ozarchie/EQMOD-ETX/Documentation/images/HBX- Message.jpg

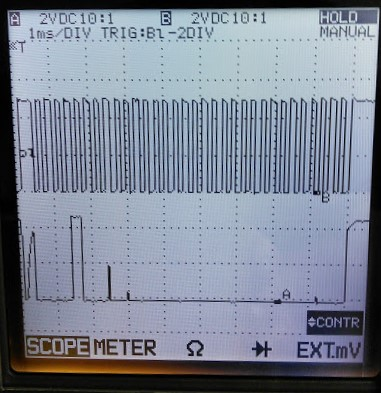
Documentation/images/HBX- Message.jpg
