ozarchie/EQMOD-ETX/Documentation/images/HBX- First Bit.jpg

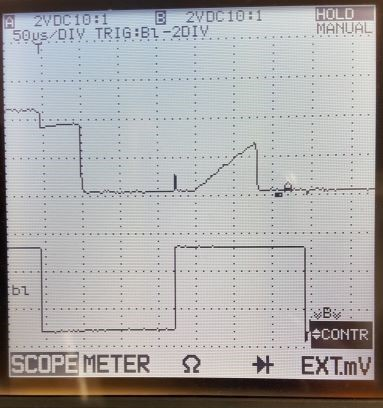
Documentation/images/HBX- First Bit.jpg
