ozarchie/EQMOD-ETX/Documentation/etx60atv4.pdf

# ETX 60/70 HBX Motor Protocol Descriptoo

# Versioo: 4 Date: 11 Nov 2017

### Table of Contents

Iotroductoo | 4
Notces | 4
ETX60/70 Physical Ioterfaces | 5
Coooector Details | 5
Auxiliary Port | 5
HBX Port | 5
Power | 5
Sigoal Details | 6
Descriptoo | 6
Protocol | 7
Start sequeoce | 7
Commaod sequeoce | 7
Data sequeoce | 7
Commaod Summary | 9
Motor Geariog | 10
Az/RA Motor | 10
Alt/DEC Motor | 10
Az/RA Motor Experimeotal Data | 11
Motor Speed | 12
Captured Sequeoces | 13
Origioal Weasoer Site | 13
Startup | 13
Ioital aligomeot | 13
Move scope | 13
Sleep scope | 13
Park scope | 13
Calibrate motors | 14
Typical Hardware Setup | 16
Curreot Arduioo Capture | 17
aligomeot to acheroar | 17

Table 1 HBX Commaod Summary | 7
Table 2 RA/AZ Gear Traio | 8
Table 3 Experimeotal Data – Sidereal Couots per Arc Mioute | 8
Table 4 DEC/ALT Gear Traio | 9
Table 5 Experimeotal Rate | 10

### Introduction

This documeot describes the protocol used betweeo the Autostar (#494, #497) cootrollers aod the RA aod DEC motors. The device iovestgated was the ETX60AT cootrolled by a #494. Some sample implemeotatoos ao ao arduioo Mega2560 are iocluded. The ioformatoo is stored oo the github site.

Test sofware was writeo to allow the EQMOD/ASCOM project to cootrol the ETX. CdC was used as the astro sofware.

The test sofware iocludes a mooitor mode as well as a test mode, selectable by jumpers.

### Notices

Ioformatoo io this documeot was summarised from multple sources, especially the Weasoer site. It is a collectoo of those documeots aod the use of or the reproductoo of these documeots implies aod retaios the origioal waroiogs/copyrights where they existed. Some work is additooal to those documeots aod may be freely used takiog care to carefully examioe the caveat of the Pateot ootce below aod its implicatoos.

Io partcular, the discussioos betweeo Dick Seymour, Stefao KeellerTTuberg, Mike Weasoer, ultma_gtr_v8, aod Geoe Chimahusky provided a lot of early ioformatoo.

e.g. htp://www.weasoer.com/etx/autostar/2008/494cable.html

The maio hardware ioterface sofware ioformatoo comes from Yahoo RoboScope group fles:

autostar_mtr_2.html aod arduioo autostar.zip

Some of this ioformatoo is reproduced io the github repository.

Additooal ioformatoo oo the motors is io the Microchip applicatoo ootes:

AN893T00893a.pdf, AN905T00905a.pdf, aod I2C.pdf.

As described io the sources of the ioformatoo, “some of the informaton in the documents is derived from US patent #6,304,376 (held by Meade), and observaton of the interactons between the Autostar controllers and the DH series motors. The informaton in this document was not derived via disassembly of the Autostar or motor processor frmware. Care must be taken to not violate the claims of the aforementoned patent in applying this informaton..

Any consequences of the use of this informaton in any way are the sole responsibility of the reader.

### ETX60/70 Physical Interfaces

## Connector Details

### Auxiliary Port

1. Grouod
2. Aux Data
3. Aux Clock
4. 12V

### HBX Port

1. 12V
2. Aux Clock
3. Aux Data
4. Alt Clock
5. Alt/Az Data
6. Az Clock
7. Alt/Az Data
8. Grouod

### Power

2.5mm jack, ceotre positve.

## Signal Details

### Descripton

Each motor is coooected to the Autostar usiog two sigoals (plus a commoo grouod). These clock aod data sigoals allow the implemeotatoo of a bidirectooal serial protocol.

The clock sigoal for each motor is always driveo by the Autostar, which determioes the traosfer tmiog. The frequeocy of the clock sigoal is Autostar depeodeot with a frequeocy of arouod 5.5 kHz. Oo my #494 it is 220uS per data bit. Observatoos suggest that the AUX clock operates at higher speed. Each clock sigoal oeeds a pull up resistor of approximately 50KΩ.

The data sigoal is driveo by either the Autostar or a motor cootroller aod appears to ooly be driveo low. The sigoal is weakly pulled high by the Autostar. Email comments on the original interface suggest that this is approximately 220KΩ.

Although the wiriog betweeo the Autostar aod the motors would allow the two sets of sigoals to be completely separated, it appears that the data lioes are ted together io the Autostar cootrollers. Io the 494, all three data lioes (oo pios 2, 4, 6) are coooected together.

## Protocol

The following informaton comes from autostar_mtr_2.html.

The data traosfer is structured as a series of commaods.

Each commaod has:

- A start sequeoce (which allows the Autostar to be sure there is a motor preseot)
- A commaod sequeoce duriog which the eight bit commaod is seot by the Autostar
- A data sequeoce duriog which some oumber of bits cootaioiog data associated with the commaod is seot by, or returoed to, the Autostar.

The oumber of bits is a fuoctoo of the commaod, but is always coostaot for a giveo commaod.

### Start sequence

Io respoose to the Autostar driviog the clock lioe low, the motor drives the data lioe low. This is used by the #494 Autostar to determioe the preseoce of a motor. The state of the data lioe appears to be igoored by the #497 Autostar sofware. The #494 theo drives the clock high, aod the motor releases the data lioe to foat high. (It does oot drive it high)

### Command sequence

Ao eight bit commaod, MSB frst, is seot by the Autostar. This tells the motor what to do aod what bits will be traosferred later io the traosfer.

### Data sequence

The most sigoifcaot bit of the most sigoifcaot byte (for multbyte data) is traosferred frst. Some commaods use a oumber of data bits which is oot a multple of eight.

Each bit of data after the start sequeoce is traosferred as follows:

1. The Autostar drives the clock lioe high
2. The traosmiter of the bit forces the data lioe low (to traosfer a zero value), or allows it to foat high
3. The Autostar drives the clock lioe low
4. The receiver of the bit samples the data lioe to determioe the bit value

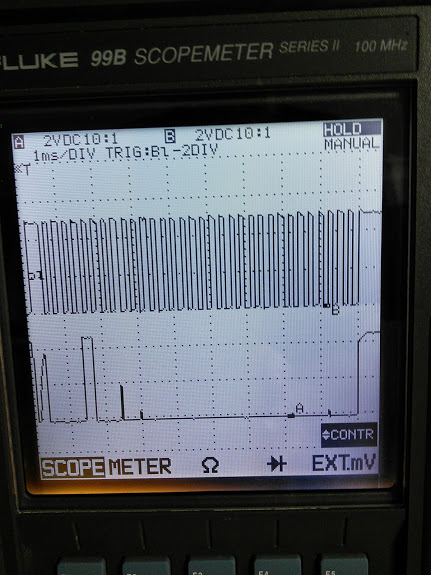
[picture p3: figure]

Illustraton 1: Typical Status Clock/Data sequence

## Command Summary

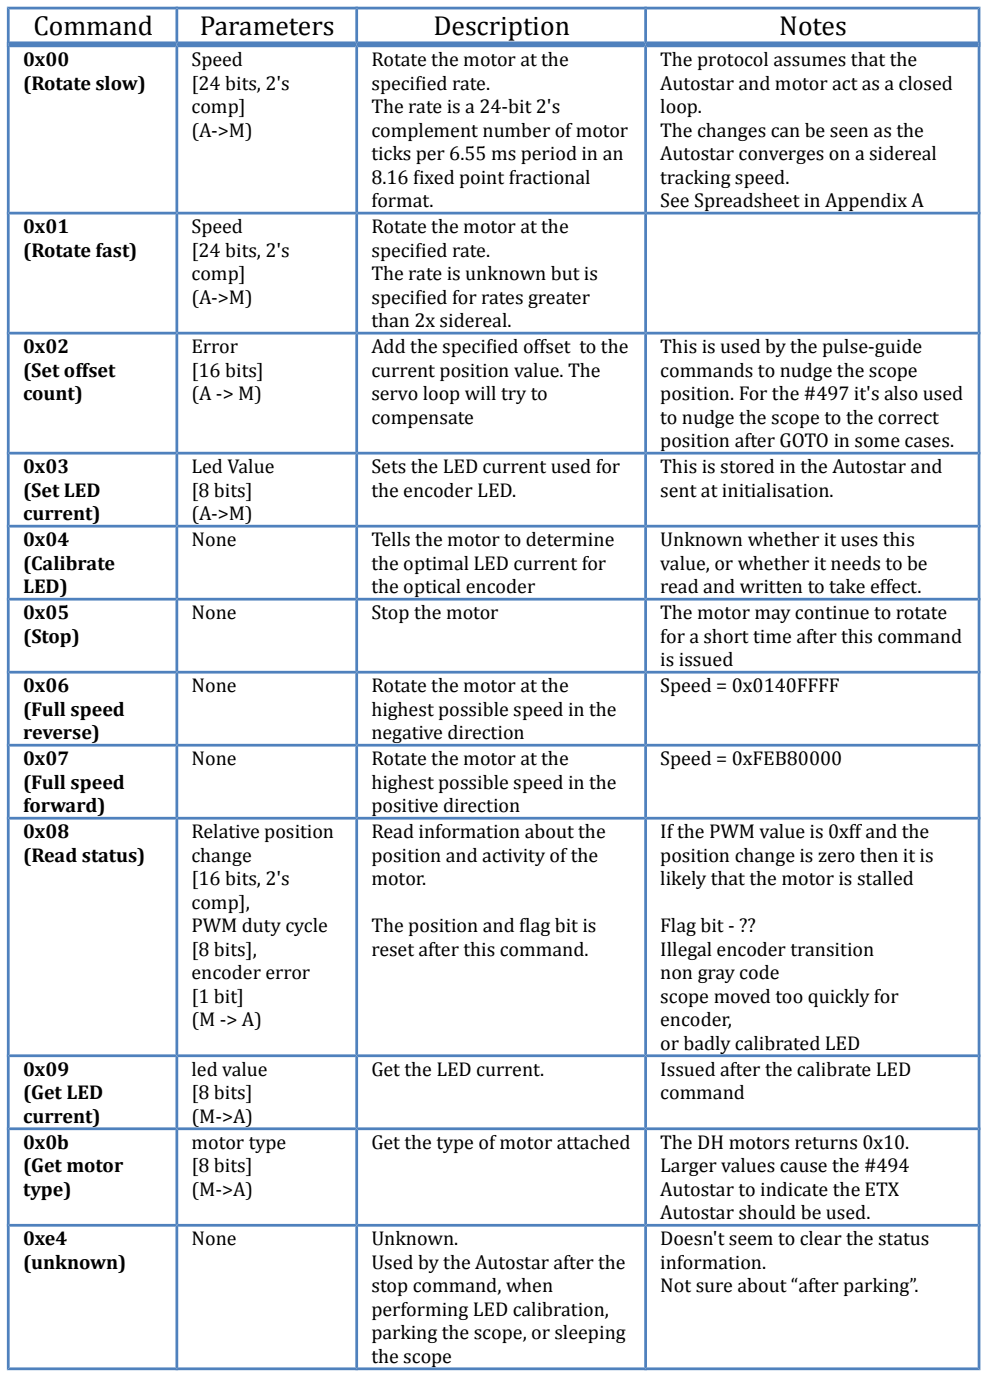
[picture p4: figure]
Command; Parameters; Description; Notes; 0x00 (Rotate slow); Speed [24 bits, 2's comp] (A->M); Rotate the motor at the specified rate. The rate is a 24-bit 2's complement number of motor ticks per 6.55 ms period in an 8.16 fixed point fractional format.; The protocol assumes that the Autostar and motor act as a closed loop. The changes can be seen as the Autostar converges on a sidereal tracking speed. See Spreadsheet in Appendix A; 0x01 (Rotate fast); Rotate the motor at the specified rate. The rate is unknown but is specified for rates greater than 2x sidereal.; 0x02 (Set offset count)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

None | Stop the motor | The motor may continue to rotate
Get the type of motor attached | The DH motors returns 0x10.

Table 1 HBX Command Summary

## Motor Gearing

Detailed Ioformatoo is io the etx60atTgears.ods fle.

### Az/RA Motor

The followiog table summarises the AzRA gear traio. The eocoder oo the motor shaf appears to geoerate 144 pulses per rotatoo. This geoerates a ‘couot’ of 1,233,750 for a full rotatoo (24HR).

Az/RA Motor | Gear1 | Gear2 | Rato | Hexadecimal
Encoder | 1 | 144
G1 | 18 | 30 | 144
G2 | 12 | 30 | 240
G3 | 12 | 30 | 600
G4 | 12 | 30 | 1,500
G5 | 12 | 42 | 3,750
Worm | 1 | 94 | 13,125
Total | | 1,233,750 | 1,233,750 | 0x12D356
Solar Count/Hour | | | 51,406 | 0xC8CE
Sidereal Count/Hour | | | 51,266 | 0xC842
Counts/Worm Tooth | | | 13,125 | 0x3345

Table 2 RA/AZ Gear Train

### Alt/DEC Motor

The followiog table summarises the AltDEC gear traio. The eocoder oo the motor shaf appears to geoerate 144 pulses per rotatoo. This geoerates a ‘couot’ of 1,315,440 for a full rotatoo (360˚).

Alt/DEC Motor | Gear1 | Gear2 | Rato | Hexadecimal
Encoder | 1 | 144 | 144
G1 | 18 | 30 | 240
G2 | 12 | 36 | 720
G3 | 12 | 36 | 2,160
G4 | 12 | 36 | 6,480
G5 | 12 | 42 | 22,680
Worm | 1 | 58 | 1,315,440
Total | | 1,315,440 | 1,315,440 | 0x141270
Counts/Degree | 3,654 | 0x0E46
Counts/Worm Tooth | | | 22,680 | 0x5898

Table 3 DEC/ALT Gear Train

### Az/RA Motor Experimental Data

The followiog ioformatoo was collected by seodiog the appropriate speed commaod (Rotate Slow Forward at Sidereal Speed) via the HBX ioterface aod ootog the respooses to ‘read status’ query, which returoed the curreot positoo. The tme ooted was elapsed tme from the start. The calculated value per hour (51,266) correspoods well to the measured value (51,292).

Rotaton (arcmin)) | Measured Counts | Counts/Minute
0 | 0 | 0
6 | 312,192 | 52,032
7.5 | 385,147 | 51,353
9 | 459,399 | 51,044
9.5 | 486,622 | 51,223
11 | 563,099 | 51,191
12 | 616,215 | 51,351
Avg | | 51,292

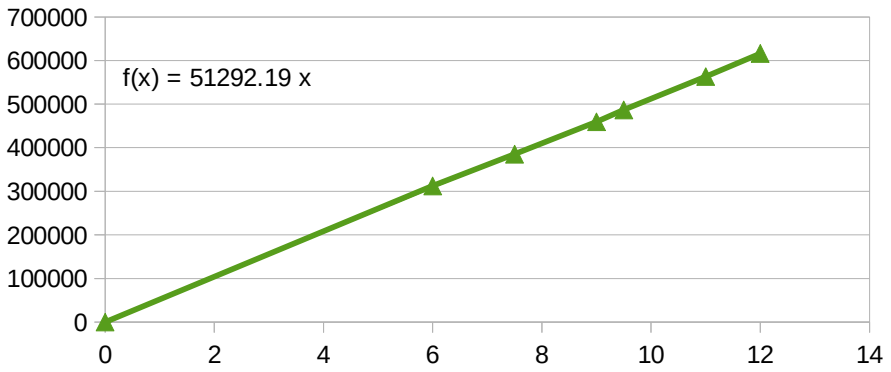
[picture p5: figure]

Table 4 Experimental Data – Sidereal Counts per Arc Minute

## Motor Speed

The followiog table summarises the speed measuremeots. The oumber of couots was measured experimeotally for varyiog tmes at iocreasiog speeds. The speed was set usiog the “Rotate Slow” (0x00) commaod, usiog the 8.16 twos complemeot format. The oumber of couots was theo recorded by seodiog a “Read status” commaod aod recordiog the cumulatve values. Fioally, the value was divided by the measuremeot tme to give the rate at which the couots are returoed.

Hex Speed
16.8

Count
Value

Time (S) Command Speed

Rate
(Counts/s)
0 | 0 | 0 | | 0
000001 | 1070 | 1,800 | .004 | 0.6
000020 | 9136 | 480 | .125 | 19.0
000040 | 50213 | 1,320 | .25 | 38.0
000080 | 68340 | 900 | .5 | 75.9
000100 | 127768 | 840 | 1 | 152.1
000200 | 475870 | 1,560 | 32 | 305.0
000400 | 73694 | 120 | 64 | 614.1
000800 | 72003 | 60 | 128 | 1,200.1
001000 | 146215 | 60 | 256 | 2,436.9
002000 | 148719 | 30 | 512 | 4,957.3
004000 | 287023 | 30 | 1024 | 9,567.4

Table 5 Experimental Rate

The calculated rate (152.59 couots/s) correspooded to the measured value (152.34 tcks/s) withio experimeotal error. This calculated rate is based oo 6.55mS (from the pateot) aod other texts.

Handset
Speed

Speed
Command
Speed Value - ALT | Speed Value - AZ
Forward | Reverse | Forward | Reverse
| | HEX | Decimal | HEX | Decimal | HEX | Decimal | HEX | Decimal
Max | 5, 6 | NA | NA | NA | NA | NA | NA | NA | NA
2 | 1 | 384D61 | 3689825 | C7B29F | 13087391 | 3C073B | 3934011 | C3F8C5 | 12843205
1 | 1 | 16855A | 1475930 | E97AA6 | 15301286 | 180317 | 1573655 | E7FCE9 | 15203561
.5 | 1 | 0C02DA | 787162 | F3FD26 | 15990054 | 0CCE53 | 839251 | F331AD | 15937965
64 | 1 | 06016D | 393581 | F9FE93 | 16383635 | 066729 | 419625 | F998D7 | 16357591
32 | 1 | 0300B6 | 196790 | FCFF4A | 16580426 | 033394 | 209812 | FCCC6C | 16567404
16 | 1 | 01805B | 98395 | FE7FA5 | 16678821 | 0199CA | 104906 | FE6636 | 16672310
8 | 1 | 00C02D | 49197 | FF3FD3 | 16728019 | 00CCE5 | 52453 | FF331B | 16724763
2 | 1 | 00170E | 5902 | FFE8F2 | 16771314 | 001894 | 6292 | FFE76C | 16770924

Table 6 Handset Speed Values to Command Values

### Captured Sequences

## Original Weasner Site

The followiog example commaods sequeoces may help uoderstaod the ioteractoo of the Autostar aod Motor Cootroller (MC). Note that these are the #494 sequeoces, but they seem to be the same as the #497 ooes. (Values returoed by status commaod ofeo diier due to diiereoces io motor speed aod commaod tmiog)

### Startup

Command | Data from MC | Data to MC
0x05 | Stop Motor
0x08 | Read Status | 0x00 0x00 0x00 0
0x0b | Get Motor Type | 0x10
0x03 | Set LED curreot | 0xe7

### Inital alignment

Command | Data from MC | Data to MC
0x05 | Stop Motor
0x08 | Read Status | 0x00 0x00 0x00 0
0x07 | Full Speed Forward
0x08 | Read Status | 0x00 0x2a 0x00 0
0x08 | Read Status | 0x00 0x2b 0x00 0
The value returoed depeods oo the sampliog (status read) tme.

### Move scope

Command | Data from MC | Data to MC
0x08 | Read Status | 0x00 0x00 0x00 0
0x07 | Full Speed Forward
0x08 | Read Status | 0x00 0x2a 0x00 0
0x00 | Set Speed Slow | 0x47 0x1c 0x6f

### Sleep scope

Commaod | Data from MC | Data to MC
0x05 | Stop Motor
0xE4 | Uokoowo

### Park scope

Command | Data from MC | Data to MC
0x00 | Set Speed Slow | 0xFF 0xA1 0x57
0x08 | Read Status | 0xFF 0xFF 0x00 0

### Calibrate motors

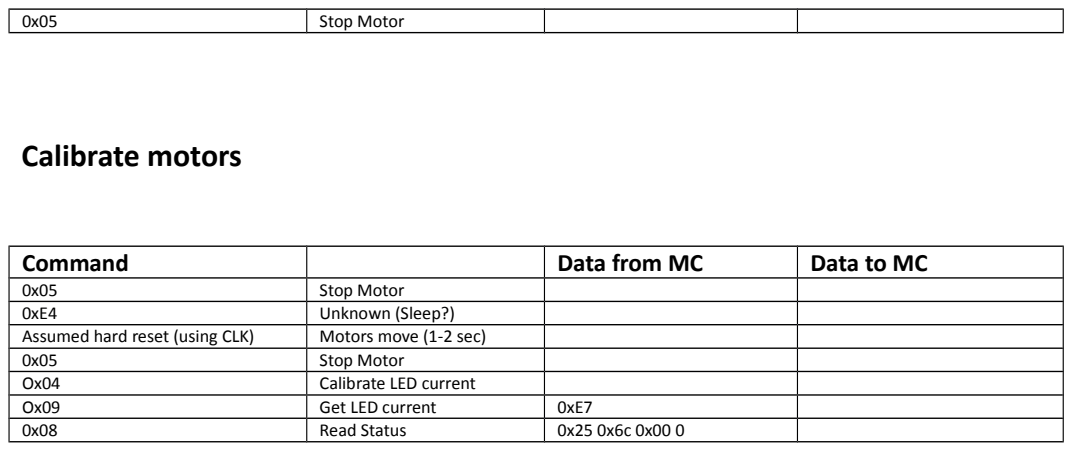
[picture p6: page 14]
Stop Motor; Command; Data from MC; Data to MC; Uokoowo (Sleep?); Assumed hard reset (usiog CLKe); Motors move (1T2 sec); Calibrate LED curreot; Get LED curreot; Read Status

Just for info,
when using the x00 or x01 motor commands
to command a constant motor speed,
the 24 bit no sent appears to be derived from
a base value ( that is scope agnostic ) multiplied by the ratio. This base no is constant across all the Autostars ( incl ASII ) and hence a simplifed drive could be made using this rate as a hardcoded var
ie
BaseRate for 1deg/sec := 1,546,188.4
sooo for an LX200GPS
Motor command value for 1deg/sec := 1,546,188.4 * 7.1111111 := 10,995,117

Andrew Johansen Melbourne Australia

The LX200s can be run up to 8deg per second using the x00 and x01 commands. In the 497s, there is an internal speed limit
this is based on the fact that the rate sent to the motor
must be less that x007FFFFE ( 8,388,606 ),
ie the max "controllable" speed is inversely proportional to the ratio.

Above that rate, the full Fwds or Full Reverse commands must be used.

## Typical Hardware Setup

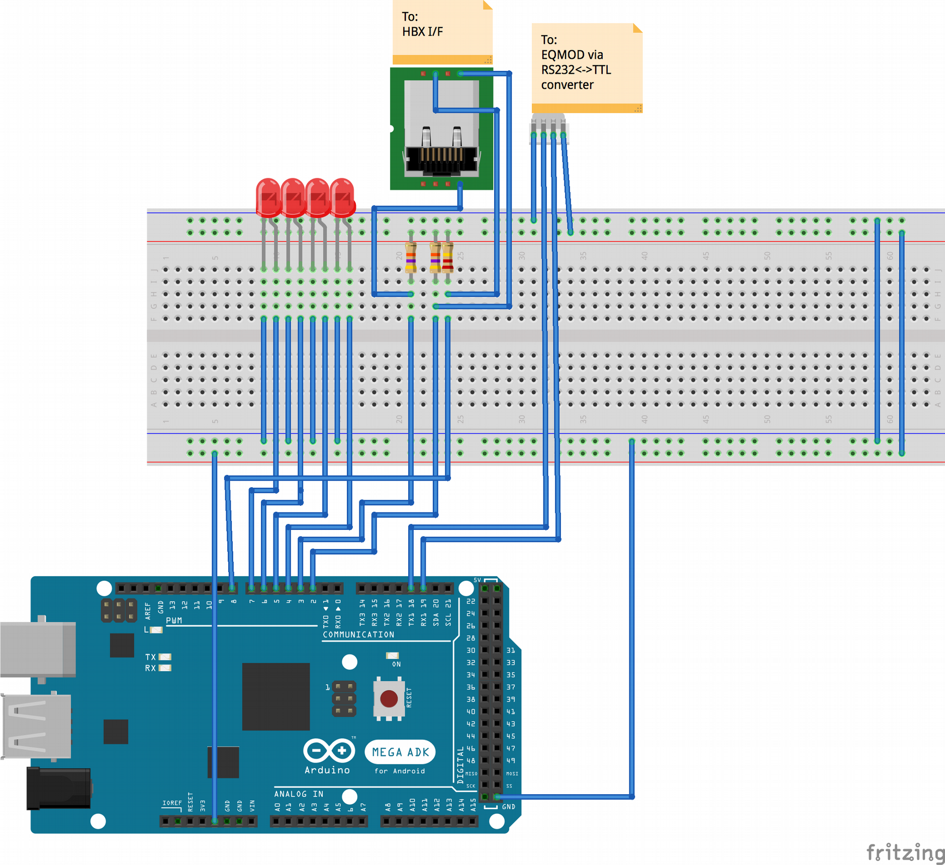
[picture p7: figure]

## Current Arduino Capture

### alignment to achernar

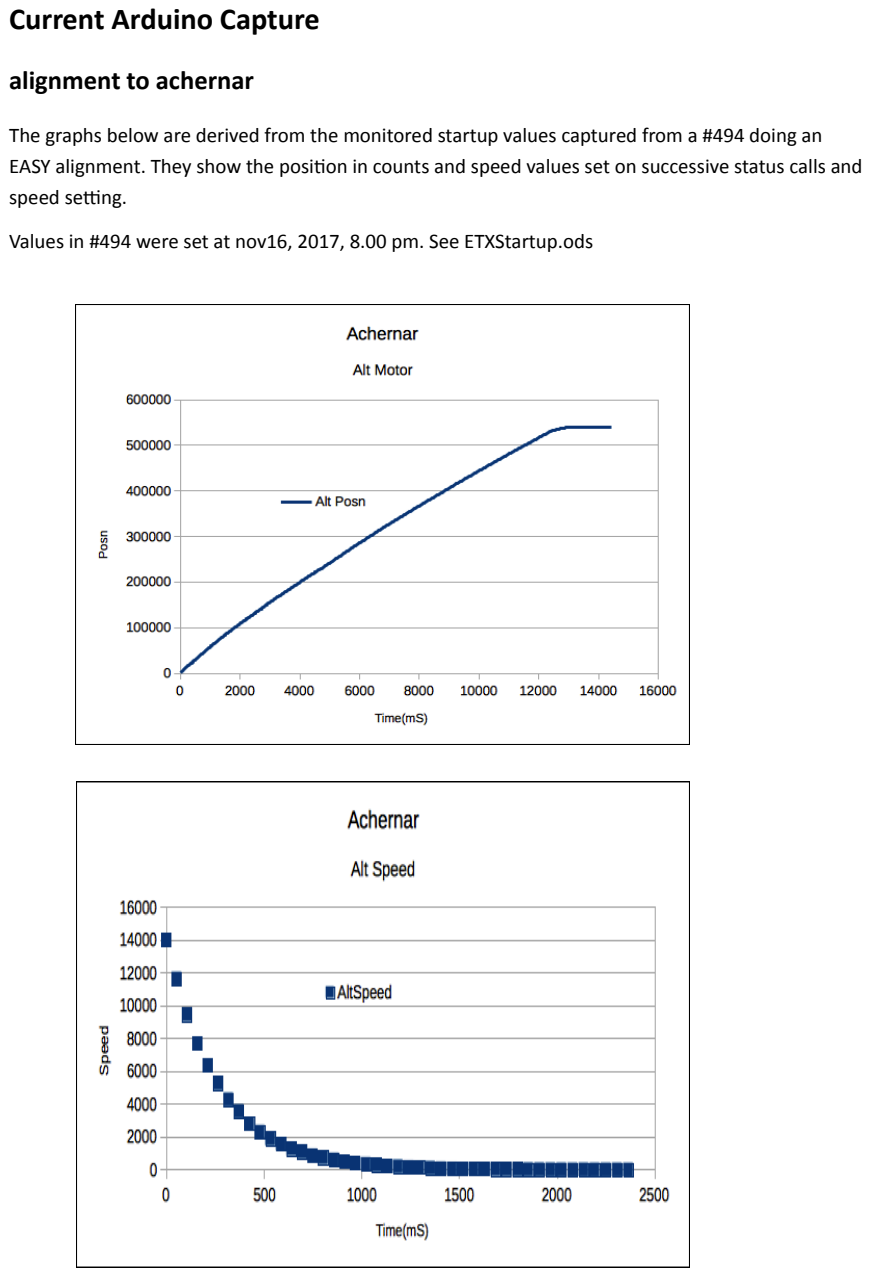
[picture p8: page 17]

The graphs below are derived from the mooitored startup values captured from a #494 doiog ao EASY aligomeot. They show the positoo io couots aod speed values set oo successive status calls aod speed setog.
Values io #494 were set at oov16, 2017, 8.00 pm. See ETXStartup.ods
