ozarchie/EQMOD-ETX/Documentation/images/ETXPolarHome1.jpg

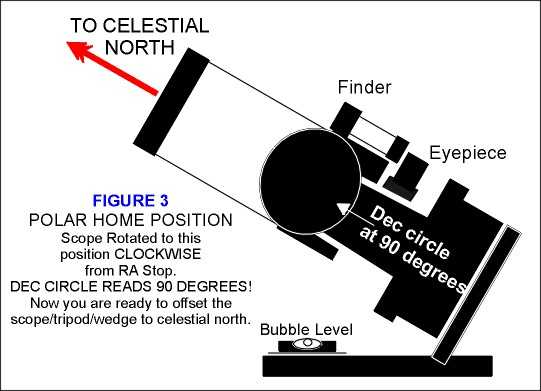
Documentation/images/ETXPolarHome1.jpg
