ozarchie/EQMOD-ETX/Documentation/images/ETXPolarHome2.jpg

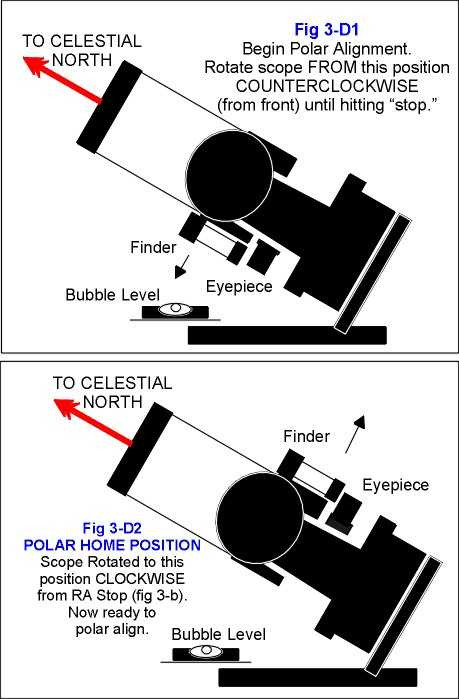
Documentation/images/ETXPolarHome2.jpg
