ozarchie/EQMOD-ETX/Hardware/EQG2HBXESP32_bb.png

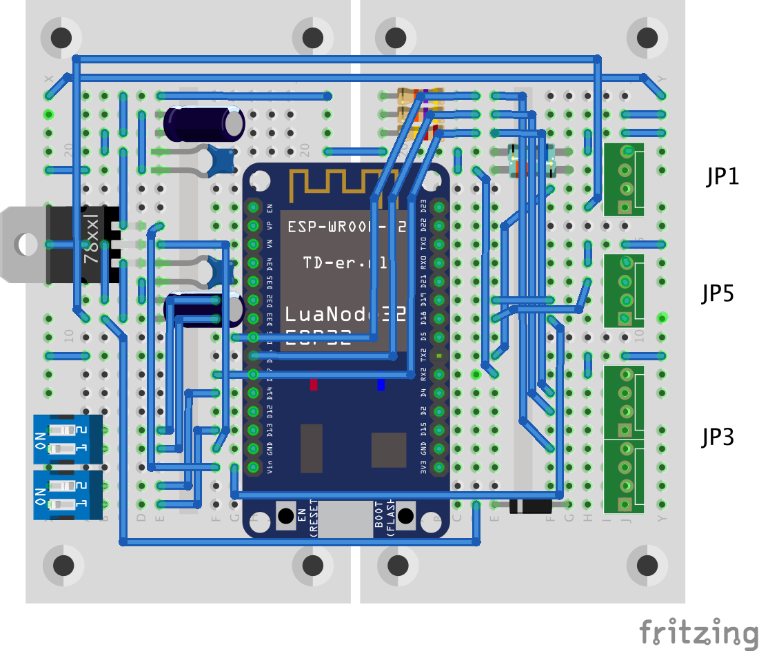
Hardware/EQG2HBXESP32_bb.png
