ozarchie/EQMOD-ETX/Hardware/EQG2HBXESP32_schem.png

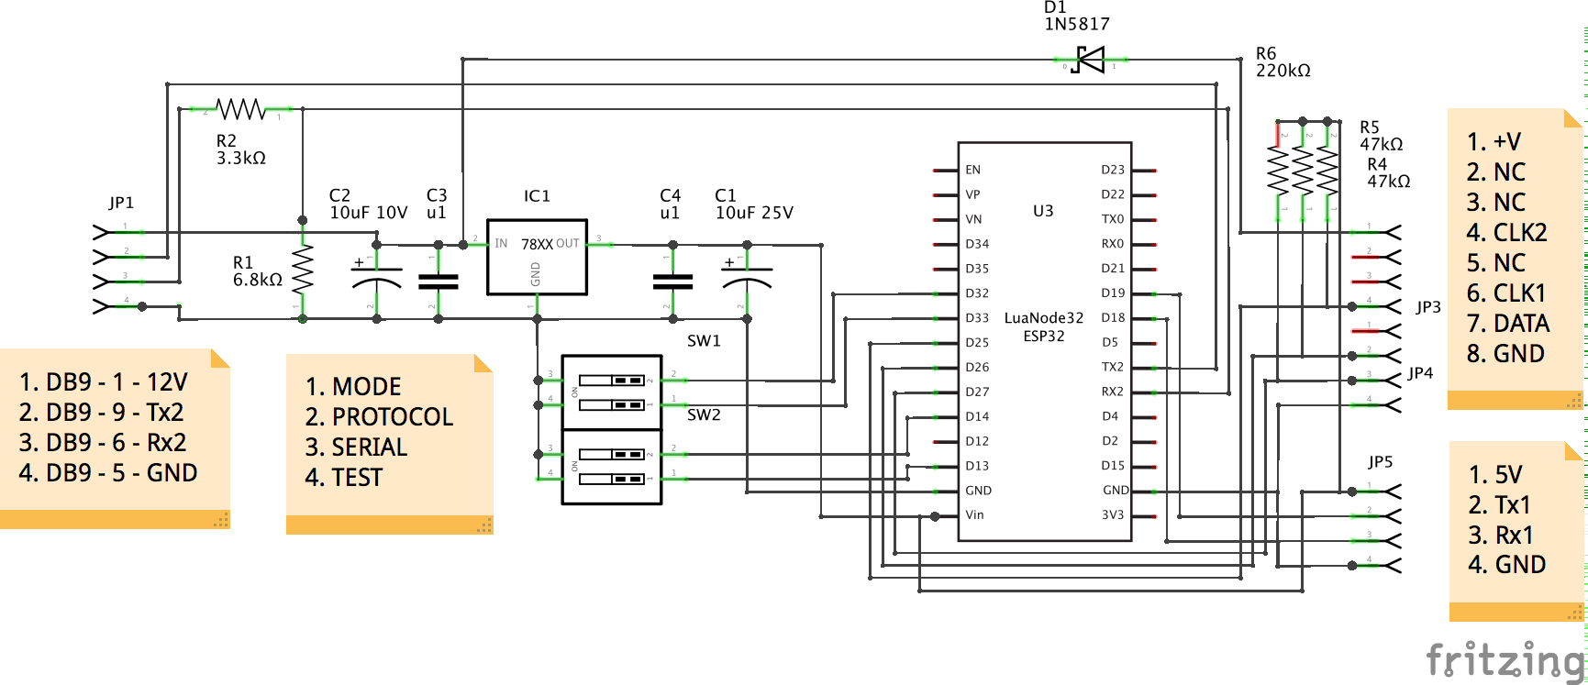
Hardware/EQG2HBXESP32_schem.png
