ozarchie/EQMOD-ETX/Hardware/HBX2EQG_bb.png

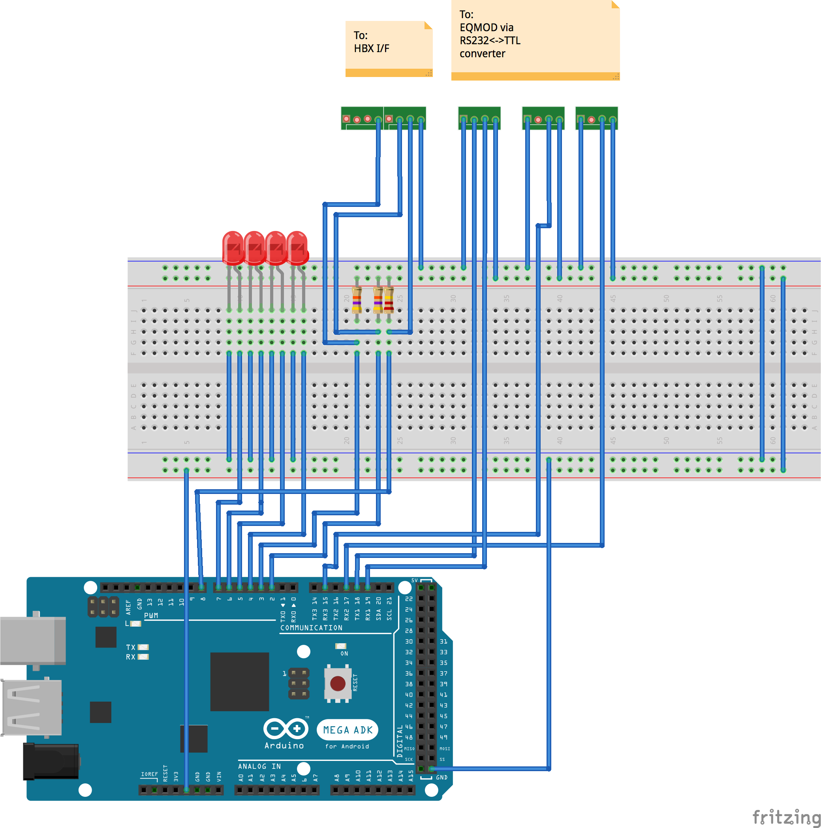
Hardware/HBX2EQG_bb.png
