ozarchie/EQMOD-ETX/Software/EQG2HBX/EQG2HBXE32/data/eq.gif

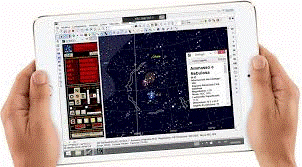
Software/EQG2HBX/EQG2HBXE32/data/eq.gif
