ozarchie/EQMOD-ETX/(threads)

Thread 2 (2021-12-18):

Setting up on Arduino

morzineIT, 2021-12-18:
Hi John,
Thanks for your work. I have ordered the ESP board from JLC, but I am a little confused
You make several reference to a an arduino controller - but all the code seems to be for an ESP
Did you move from Arduino to ESP to get wifi functionality ?
Is there a pure arduino version ? It looks like the level shifting would be easier with arduino - plus I have a mega sat on my desk, and I have to wait for the ESP PCB to come from China

Sorry to raise this as an issue, but it seems the only way to have comms on this platform

Lee

ozarchie, 2021-12-19:
Hi Lee,
No problems.
I have not worked on this for a while, but I will help you as much as I can.
The ESP was chosen for combined BT/WiFi functionality.
The Meade ETX series has an internal battery that makes it a neat portable unit.
The motivation for using the Skywatcher protocol was twofold.

1. I was familiar with EQMOD, so I could see the benefits of the PC based planetarium programs - moon mosaic, view list etc
2.  I was using the Skywatcher phone app, which allowed me a nice portable unit for grandkids.

The arduino code was implemented in the early days to debug what I could of the protocol. But now I use platformIO as it is a much better development platform. You can easily use the mega, but will lose the WiFi functionality. You may also have to look at the EEPROM libraries for storage.

morzineIT, 2021-12-19:
Thanks for your response.
Like you I got into astro/electronics to inspire my kids (grandkids in your
case)
I have done quite a few astro-automation projects (dome, focuser,filters
etc) and want to be able to get deeper inside the mount software /hardware.
I have ordered a copy if the pcb you designed, but won't receive it for a
week or two.
I have the mega on my desk and it seems to make the level shift easier.

would the 50k /220k resistor combination apply to the arduino voltages or
is that for 3.3v ?

It occurred to me that the new arduino mega with esp onboard may be the
easiest solution now. I have one, but haven't used it at all yet.

I think that combined with a raspberry pi, we could create an open source
version if the 'smart scopes' (unistellar etc). It would be very cool to
take a scope in your backpack, battery powered that you could pop down, do
some automated plate solving and be imaging in minutes.  My main astro gear
is RASA, so curious friends always want to tske a look and I see this as a
way to do that.

Would it be okay if I run questions by you from time to time please ?

regards

Lee

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

ozarchie, 2021-12-19:
Hi Lee,

No problems with giving you some help.

I am away on Festive duties at the moment, but will put some assembly photos in the documentation section when I get back home.

I hope you realize this code translates low-level motor control protocol for the Meade ETX series to low level motor control protocol for the Skywatcher EQx series. This effectively allows the Meade ETX mount to masquerade as an EQx mount.

I am not sure it has much application for the RASA{Celestron protocol} series.

Maybe TennAstro (https://groups.io/g/TeenAstro/wiki/7361) or OnStep (https://onstep.groups.io/g/main/wiki/3860) would be more appropriate.

morzineIT, 2021-12-19:
great thanks.
No, my point was thst RASA scopes are camera only - no visual. I'm trying
to create a small portable rig (meade) that works alongside my msin system.
Plus I bought the meade cheap as it had no handset

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

Thread 3 (2022-01-29):

Controlling ETX/HBX from an RPi GPIO

XenonofArcticus, 2022-01-29:
Is it possible to port the ESP32 or Arduino versions of the code to run on a RPi using GPIO? I'd like to have more processing and communications/interfacing capability available than is possible with the Arduino.

ozarchie, 2022-01-29:
It is indeed possible, but a lot of work!
All the code is based on Arduino, which has simplified c-code to deal with complex issues such port bit manipulation, serial device handling and WiFi/Bluetooth.
me-no-dev has created a way to compile with Raspi as a target:
https://www.deviceplus.com/raspberry-pi/how-to-run-arduino-sketches-on-raspberry-pi/
Maybe this could work.

XenonofArcticus, 2022-01-30:
Awesome. That's a great start.

I'm actually only interested in the low level motor control, to guide an
ETX with a webcam to watch passing aircraft (from ADSB) and maybe
spacecraft (from emphemeris) so I don't need the upper levels of the stack.

If I get something working I'll contribute what I have.

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

ozarchie, 2022-01-30:
These discussions and French document may help ..
https://groups.io/g/RoboScope/topic/autostar_clone/46118517

On Mon, Jan 31, 2022 at 2:25 AM XenonofArcticus ***@***.***>
wrote:

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

Thread 4 (2022-04-05):

Linux ESP32 library configuration

Upcycle-Electronics, 2022-04-05:
Hi John,
  I know this is an older project but I hope you are able to clarify some details if you get the chance. I am attempting to replicate your project using the Arduino IDE and Linux as a baseline. I am taking notes to maybe share with others. I am no hacker-dev but this isn't my first microcontroller project either. I have a couple of ESP32 boards and an ETX-60AT. I currently have the Arduino IDE running with your project loaded. I fixed all of the compilation errors that came up due to missing libraries, and I can compile the project in the IDE.

**1.** You listed the Espressif IDF and Platform IO install in your documentation but I did not see the version of the Arduino-cli/Espressif IDF you used. I don't think this is really important at this point, but in the future it might help others if they knew _what version was used_ or the last known to work, which I may be able to share soon.
**2.** The only library issue I came across was from the included SPIFFS.h and SPIFFSEditor.h files. My research indicates these files are from https://github.com/me-no-dev/ESPAsyncWebServer and https://github.com/me-no-dev/AsyncTCP . As far as I can tell these are not packaged for the Arduino IDE with the same syntax you used in the project. I had to clone them, compress the files in their respective src folders into zip files and add them to the Arduino IDE manually using the Library Manager. After this step everything compiles without errors. _Are these the libraries you used?_
**3.** I would like to try to use a TTGO T8 V1.7 ESP32 board for the project if I can get it to work. It has a lithium battery charge controller on board (but no discharge protection and maybe a poor regulator design). I am not asking for your help on my hardware tangent. As far as general project documentation: _what is the ESP32 configuration you used_ and are any of the specific hardware configuration options of the ESP32 important here? If you open the Arduino IDE with Espressif IDF added to the board manager list in Preferences, and set the board to the generic "ESP32 Dev Module" you will see the options I am looking to clarify in context. I can trial and error my way through this if needed. The options are: Cores configuration for events and code execution(Core0:code/Core1:Events?), the CPU/Flash frequencies (80 or 40MHz), the flash mode(QIO/DIO/QOUT/DOUT), and the memory partition scheme(SPIFFS/OTA/etc. | Default= 4mb w/spiffs (1.2mb app/1.5mb spiffs)).  I apologize if these should be obvious. I have not used the ESP32 much in the past.
**4.** Lastly, at the highest level of your project here, _are the possible hardware configurations_:

- ETX-AUX -> 1x ESP32 with WiFi server -> software connected device
- ETX-AUX -> 1x ESP32 with Bluetooth server -> software connected device
- ETX-AUX -> Arduino Mega -> 1x ESP32 with WiFi server -> software connected device
- ETX-AUX -> 1x ESP32 with ESPNOW -> 1x ESP32 with ESPNOW -> TTL Serial -> Computer
- ETX-AUX -> 1x ESP32 with ESPNOW -> 1x ESP8266 with ESPNOW -> TTL Serial -> Computer

Thanks for sharing the project and taking the time to read this.
-Jake

ozarchie, 2022-04-06:
Hi Jake,

Yes, it is a very old project, but as luck would have it I have been playing with it lately.
Unfortunately, I have not progressed the ESPNOW version which would have allowed multiple peripherals (focusser, heater, etc) to be connected.

Connection via serial (USB or BT) worked, but was really superceded when Skywatcher released their Synta mobile app. This now allows you to control the ETX using the Synta app (https://skywatcher.com/download/software/synscan-app/) and a WiFi link.

The main software issue that remains is dealing with the fact that the ETX is a fork mount, and moreover cannot go past the meridian. Synta has an ALT/AZ mount, but it is not a fork mount, but a GEM used in ALT/AZ mode. The OTA is at the side and can use standard meridian flip.

I use platformio and VSCode, so the libraries are handled automatically. If you want to do a pull request, I will update the repository.

1. I will compile under Arduino and confirm the issues you have raised and identify the releases.
2. Yes, those were the libraries, and are handled automatically under platformio.ini
3. I am currently looking at OTA for program updates, but have only just started. This will affect the ESP32 memory model, but it is not yet finalized. The SPIFFs files system is used to hold configuration parameters. The only temperamental parts is the AUX interface. On the old ETX60xx the Dats lines were intelnally joined on the motor control boards, so it paralleled the PURs on the interface. This overwhelmed the motor control boards so some PURs had to be removed. This is not the case for later Meade interfaces which have the data/clock lines seperated. Other than that, I have iused TTGO boards for similar projects on this mount - comms monitoring etc.
4. Correct, that was the original intent some 10 years ago. But mobile phone apps and an easy implementation of UDP comms have changed the focus.

Cheers
John

Upcycle-Electronics, 2022-04-06:
Hey John,Sketch uses 785337 bytes (59%) of program storage space. Maximum is 1310720 bytes.
Global variables use 45724 bytes (13%) of dynamic memory, leaving 281956 bytes for local variables. Maximum is 327680 bytes.
esptool.py v3.1
Serial port /dev/ttyUSB0
Connecting....
Chip is ESP32-D0WDQ6 (revision 1)
Features: WiFi, BT, Dual Core, 240MHz, VRef calibration in efuse, Coding Scheme None
Crystal is 40MHz
MAC: ac:67:b2:2a:8a:ec
Uploading stub...
Running stub...
Stub running...
Changing baud rate to 921600
Changed.
Configuring flash size...
Flash will be erased from 0x0000e000 to 0x0000ffff...
Flash will be erased from 0x00001000 to 0x00005fff...
Flash will be erased from 0x00010000 to 0x000d1fff...
Flash will be erased from 0x00008000 to 0x00008fff...
Compressed 8192 bytes to 47...
Writing at 0x0000e000... (100 %)
Wrote 8192 bytes (47 compressed) at 0x0000e000 in 0.1 seconds (effective 477.5 kbit/s)...
Hash of data verified.
Compressed 18496 bytes to 12721...
Writing at 0x00001000... (100 %)
Wrote 18496 bytes (12721 compressed) at 0x00001000 in 0.5 seconds (effective 300.7 kbit/s)...
Hash of data verified.
Compressed 791104 bytes to 500400...
Writing at 0x00010000... (3 %)
Writing at 0x0001b66a... (6 %)
Writing at 0x00026945... (9 %)
Writing at 0x00033bf7... (12 %)
Writing at 0x00039810... (16 %)
Writing at 0x0003f56d... (19 %)
Writing at 0x00044fc5... (22 %)
Writing at 0x0004a3f7... (25 %)
Writing at 0x0004fc26... (29 %)
Writing at 0x00054eac... (32 %)
Writing at 0x0005a172... (35 %)
Writing at 0x0005f48c... (38 %)
Writing at 0x000647a2... (41 %)
Writing at 0x00069903... (45 %)
Writing at 0x0006eb87... (48 %)
Writing at 0x00073cd4... (51 %)
Writing at 0x000796d4... (54 %)
Writing at 0x0007ea0a... (58 %)
Writing at 0x00083cb3... (61 %)
Writing at 0x000890d2... (64 %)
Writing at 0x0008e766... (67 %)
Writing at 0x00093e2b... (70 %)
Writing at 0x00099843... (74 %)
Writing at 0x0009f55a... (77 %)
Writing at 0x000a4e6a... (80 %)
Writing at 0x000ae16e... (83 %)
Writing at 0x000b5865... (87 %)
Writing at 0x000bb345... (90 %)
Writing at 0x000c3134... (93 %)
Writing at 0x000c88b9... (96 %)
Writing at 0x000cdf95... (100 %)
Wrote 791104 bytes (500400 compressed) at 0x00010000 in 7.8 seconds (effective 807.9 kbit/s)...
Hash of data verified.
Compressed 3072 bytes to 128...
Writing at 0x00008000... (100 %)
Wrote 3072 bytes (128 compressed) at 0x00008000 in 0.1 seconds (effective 355.5 kbit/s)...
Hash of data verified.

Leaving...
Hard resetting via RTS pin...
  I think I may need to copying your setup more closely. In the past I tried running Atom with Platform IO but it was really slow and the sw likes to make weird unsolicited network connections. As I understand it, VS does the same thing. I do not run windows at all. I was trying to run Arduino as an universal documentation baseline. I prefer to use an entirely FOSS toolchain whenever possible. I will also need to see if the Android app will work for me. I run a custom ROM on my phone without any google services. I may need to setup an old Android device just for this purpose if the Skywatcher app doesn't play nice. I was really hoping to get something working with software on a computer and playing around with a webcam. What prevents a program like KStars from interacting with your software if it has Synscan ASCOM control capabilities? Also, will your software work with a wedge on the ETX-60?

I have tried to upload the compiled project onto the board I have but I keep getting the same error:

```
assert failed: tcpip_send_msg_wait_sem IDF/components/lwip/lwip/src/api/tcpip.c:455 (Invalid mbox)

Backtrace:0x400835b9:0x3ffb24c00x4008b661:0x3
```ffb24e0 0x40090b05:0x3ffb2500 0x400f3262:0x3ffb2630 0x40103289:0x3ffb2660 0x401032e9:0x3ffb2680 0x400f2a55:0x3ffb26d0 0x400de71a:0x3ffb26f0 0x400de7a5:0x3ffb2730 0x400dfb36:0x3ffb2760 0x400d2caf:0x3ffb27b0 0x400d530e:0x3ffb27f0 0x400e1e02:0x3ffb2820

ELF file SHA256: 0000000000000000

Rebooting...
ets Jun  8 2016 00:22:57

rst:0xc (SW_CPU_RESET),boot:0x13 (SPI_FAST_FLASH_BOOT)
configsip: 0, SPIWP:0xee
clk_drv:0x00,q_drv:0x00,d_drv:0x00,cs0_drv:0x00,hd_drv:0x00,wp_drv:0x00
mode:DIO, clock div:2
load:0x3fff0030,len:1324
ho 0 tail 12 room 4
load:0x40078000,len:13480
ho 0 tail 12 room 4
load:0x40080400,len:3604
entry 0x400805f0
```
I tried both Flash frequencies, uploading to Core0/1 for code/events but those did not change the error. I also tried different combinations of reset and boot button but I have not seen anything change. I can't even say if the code is uploaded properly. At the end of this message I have included the Arduino terminal output for my last attempt to compile and load the code. This attempt may have been one of the ones where I tried to comment out the #define mTEST line just to see what might change. I have also searched the first line of the serial output error online. It seems like others have said this may be due to the ArduinoOTA library, (https://github.com/arkhipenko/TaskScheduler/issues/136). I will try to look into this further after getting back from my physical therapy routine later this evening.

```
Sketch uses 785337 bytes (59%) of program storage space. Maximum is 1310720 bytes.
Global variables use 45724 bytes (13%) of dynamic memory, leaving 281956 bytes for local variables. Maximum is 327680 bytes.
esptool.py v3.1
Serial port /dev/ttyUSB0
Connecting....
Chip is ESP32-D0WDQ6 (revision 1)
Features: WiFi, BT, Dual Core, 240MHz, VRef calibration in efuse, Coding Scheme None
Crystal is 40MHz
MAC: ac:67:b2:2a:8a:ec
Uploading stub...
Running stub...
Stub running...
Changing baud rate to 921600
Changed.
Configuring flash size...
Flash will be erased from 0x0000e000 to 0x0000ffff...
Flash will be erased from 0x00001000 to 0x00005fff...
Flash will be erased from 0x00010000 to 0x000d1fff...
Flash will be erased from 0x00008000 to 0x00008fff...
Compressed 8192 bytes to 47...
Writing at 0x0000e000... (100 %)
Wrote 8192 bytes (47 compressed) at 0x0000e000 in 0.1 seconds (effective 477.5 kbit/s)...
Hash of data verified.
Compressed 18496 bytes to 12721...
Writing at 0x00001000... (100 %)
Wrote 18496 bytes (12721 compressed) at 0x00001000 in 0.5 seconds (effective 300.7 kbit/s)...
Hash of data verified.
Compressed 791104 bytes to 500400...
Writing at 0x00010000... (3 %)
Writing at 0x0001b66a... (6 %)
Writing at 0x00026945... (9 %)
Writing at 0x00033bf7... (12 %)
Writing at 0x00039810... (16 %)
Writing at 0x0003f56d... (19 %)
Writing at 0x00044fc5... (22 %)
Writing at 0x0004a3f7... (25 %)
Writing at 0x0004fc26... (29 %)
Writing at 0x00054eac... (32 %)
Writing at 0x0005a172... (35 %)
Writing at 0x0005f48c... (38 %)
Writing at 0x000647a2... (41 %)
Writing at 0x00069903... (45 %)
Writing at 0x0006eb87... (48 %)
Writing at 0x00073cd4... (51 %)
Writing at 0x000796d4... (54 %)
Writing at 0x0007ea0a... (58 %)
Writing at 0x00083cb3... (61 %)
Writing at 0x000890d2... (64 %)
Writing at 0x0008e766... (67 %)
Writing at 0x00093e2b... (70 %)
Writing at 0x00099843... (74 %)
Writing at 0x0009f55a... (77 %)
Writing at 0x000a4e6a... (80 %)
Writing at 0x000ae16e... (83 %)
Writing at 0x000b5865... (87 %)
Writing at 0x000bb345... (90 %)
Writing at 0x000c3134... (93 %)
Writing at 0x000c88b9... (96 %)
Writing at 0x000cdf95... (100 %)
Wrote 791104 bytes (500400 compressed) at 0x00010000 in 7.8 seconds (effective 807.9 kbit/s)...
Hash of data verified.
Compressed 3072 bytes to 128...
Writing at 0x00008000... (100 %)
Wrote 3072 bytes (128 compressed) at 0x00008000 in 0.1 seconds (effective 355.5 kbit/s)...
Hash of data verified.

Leaving...
Hard resetting via RTS pin...
```
Thanks for the quick reply.
-Jake

Upcycle-Electronics, 2022-04-06:
I can confirm my TTGO T8 board works with the Arduino IDE's "Get Chip ID" sketch and returns a value on the serial terminal.

I am currently testing the board without any external connections if that makes any difference. I can build it on a breadboard at any time. I have also checked and at first pass glance, the T8 board is labeled with the same pins available as the project documentation board.

The Skywatcher Android app also works with an AOSP Graphine ROM, and does not include any trackerware or other oddities that I can see, if anyone cares about this kind of thing. While I have not been able to test connectivity and functions, the apk opens and appears to work as intended.

Here is where I am at with installation notes so far:
```
ARDUINO IDE
. Install the latest 1.X.X Arduino IDE from - https://www.arduino.cc/en/software (tested: 1.8.19@linux 64b)
. uncompress > nav to directory > run $ ./arduino-linux-setup.sh
. Nav to https://docs.espressif.com/projects/arduino-esp32/en/latest/installing.html (or equivolent docs.espressif.com > arduino-esp32 > latest > installation) and follow instruction to install IDF in arduino IDE which was source for instructions as follows
. Open Arduino IDE > File > Preferences and under "Additional Board Managers" add: https://raw.githubusercontent.com/espressif/arduino-esp32/gh-pages/package_esp32_index.json
. Then navigate to Tools > Board (selected) > Boards Manager and search and install esp32
. Next $ git clone https://github.com/me-no-dev/ESPAsyncWebServer
. navigate to ../ESPAsyncWebServer/src/
. compress all files in ../src/ into a single zip file
. In the Arduino IDE goto Sketch > Include Library > Add Zip > (src files zip)
. Next git clone https://github.com/me-no-dev/AsyncTCP
. navigate to ../AsyncTCP/src/
. compress all files in ../src/ into a single zip file
. In the Arduino IDE goto Sketch > Include Library > Add Zip > (src files zip)
. If using Ubuntu or any distro with python installed as "python3" run $ sudo apt-get install python-is-python3
. next check if pyserial is installed or just try to install it $ sudo apt-get install python3-serial*
. now $ git clone https://github.com/ozarchie/EQMOD-ETX
. open the Arduino IDE and open ../EQMOD-ETX/Software/EQG2HBXWiFi/EQG2HBXWiFi.ino
. the IDE should import all of the files in this folder as tabs automatically
. these are the steps it took for me to get this file to compile on Ubuntu 20.04
. also note that I am not telling you how to organize your computer. I use shorthand like ../src/. The ../ means go to this directory level wherever you decided to put it.

LINUX HARDWARE ACCESS
. Check that user has USB hardware control access by looking for "plugdev" after running command= $ groups $USER
. If not run command = $ sudo usermod -a -G dialout $USER
. Note the board's vendor ID and product ID by connecting the ESP32 board to the computer and run $ lsusb
The results should look like: 10c4:ea60 Silicon Labs CP210x UART Bridge
. Next use the command $ sudo nano /etc/udev/rules.d/50-eqmod-etx.rules
. Add the text line: ATTR{idVendor}=="10c4", ATTRS{idProduct}=="ea60", MODE="660", GROUP="dialout"
. Finally press Ctrl+x and then y to save the new rule file.

https://github.com/ozarchie/EQMOD-ETX
https://docs.espressif.com/projects/arduino-esp32/en/latest/installing.html
https://www.arduino.cc/en/software
https://www.gnu.org/software/bash/manual/bash.html#Bash-Variables
https://github.com/me-no-dev/ESPAsyncWebServer
https://github.com/me-no-dev/AsyncTCP
https://forum.arduino.cc/t/esp32-compile-error-python-exe-missing-solved/953279
https://wiki.archlinux.org/title/Users_and_groups
```

ozarchie, 2022-04-06:
Hi Jake,
I just tried compiling all the software online. They all compile.

However, when I tried to upload and run, the EQG2HBXWiFi project gave an
error.
It has an mistake on line 117 where the StartOTAIfRequired(); is called
before  HBXWiFiSetup(); on line 127.
Just comment out or delete line 117.
I will make the change to the repo.

FYI, Arduino 1.8.16 (Windows10) found the libraries for me, so I am not
sure what is happening on linux.

I will continue checking this weekend and verify the projects against the
current Synscan app.
I have mainly been testing against a serial EQMOD install usinf EQG2HBXE32
project.
I really need to find a better way to manage the code.

Cheers
John

On Wed, Apr 6, 2022 at 11:14 AM Jake Little ***@***.***>
wrote:

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

Upcycle-Electronics, 2022-04-06:
Hey you fixed it!
Removing line 117 got it working. Thanks! It boots to:

```
ets Jun  8 2016 00:22:57

rst:0x10 (RTCWDT_RTC_RESET),boot:0x3f (SPI_FAST_FLASH_BOOT)
flash read err, 1000
ets_main.c 371
ets Jun  8 2016 00:22:57

rst:0x10 (RTCWDT_RTC_RESET),boot:0x13 (SPI_FAST_FLASH_BOOT)
configsip: 0, SPIWP:0xee
clk_drv:0x00,q_drv:0x00,d_drv:0x00,cs0_drv:0x00,hd_drv:0x00,wp_drv:0x00
mode:DIO, clock div:2
load:0x3fff0030,len:1324
ho 0 tail 12 room 4
load:0x40078000,len:13480
ho 0 tail 12 room 4
load:0x40080400,len:3604
entry 0x400805f0
EQG2HBX V1.05
EQMODWiFi Access Point Mode
SoftAP IP address: 192.168.88.1
ssid: EQMODWiFi
pass: CShillit0
UDP Mode
UDP2SerialServer
Now listening at IP 192.168.88.1, UDP port 11880
digitalRead(TESTHBX)  : 1
HBX Initialization
Telescope: 0, ETX60
Protocol: 0, Station: 0, AzMotor:  Vanes 36, GbxRatio 91.1458, XferRatio 1.0000, WormTeeth 94, MeadeRatio 0.951968
AltMotor: Vanes 36, GbxRatio 157.5000, XferRatio 1.0000, WormTeeth 58, MeadeRatio 1.015000
AzMotor
Vanes 36, GbxRatio 91.1458, XferRatio 1.0000, WormTeeth 94
MeadeRatio 0.951968, MeadeSidereal 6460.0898
aVALUE 0x12D356, bVALUE 0x157F8, PEC 0x3345
SIDEREALRATE 0x1805, SOLARRATE 0x1815, LUNARRATE 0x18E5, DEGREERATE1 0x1684B0
One DEGREE 0xD63

AltMotor
Vanes 36, GbxRatio 157.5000, XferRatio 1.0000, WormTeeth 58
MeadeRatio 1.015000, MeadeSidereal 6460.0898
aVALUE 0x141270, bVALUE 0x18707, PEC 0x5898
SIDEREALRATE 0x199C, SOLARRATE 0x19AD, LUNARRATE 0x1A8B, DEGREERATE1 0x180240
One DEGREE 0xE46

Waiting for both motors to start up ..

+++ 1
+++ 2
```
 Now I just need to cobble together the circuit and start testing. I built PlatformIO-cli today, and am playing with it now. Apparently it is possible to build a version of VSCode from source. I may look into it further in the future.

I tried passing this project through doxygen/doxywizard/graphviz but it doesn't work with arduino code. Do you know of any documentation generation tools that help break down Arduino code? This project isn't super complicated, but I am not super bright either.
-Jake

ozarchie, 2022-04-07:
Rename the .ino files to .c and try deoxygenated again.

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
