ozarchie/EQMOD-ETX/(commit log)

2018-01-02 Update documentation
    [ETXStartupV3.ods, etx60at-gears.ods]
2018-08-04 Nearly done
    The ETX mount is AltAz and the EQG is setup for GEM.
    The ETX needs a wedge to use it in GEM mode.
    There is still work to be done on the initial settings for Northern and Southern hemisphere.
    I am just waiting for Qantas to offer me a trip to London to test it out :)
2018-09-19 ESP32 update
2018-09-19 BETA PRE-RELEASE VERSION OF ESP32 CODE
2018-10-02 UPDATED SCHEMATICS
2019-02-10 Update for V2 hardware
    Update for latest hardware
    Currently in test.
2021-12-20 Arduino compile tests for V1.8.16
    Separate compile folders for Mega, ESP32 serial, and ESP32 WiFi.
    PC Synscan will work with all, Synscan Mobile only with WiFi.
2022-06-13 Update for VSCode
    Change to code base to use:
    1. VSCode for intellisense etc
    2. Platformio for library management.
    The code still compiles under arduino, but requires that the correct libraries are selected/loaded.
    [EQG2HBX.h, EQG2HBXE32.ino, EQGProtocol.h, EQGProtocol.ino, ETXProtocol.h, ETXProtocol.ino, HBXComms.h, HBXComms.ino]
